mgierhart/Roku-ESP32-Remote/hardware/stl/lid.stl

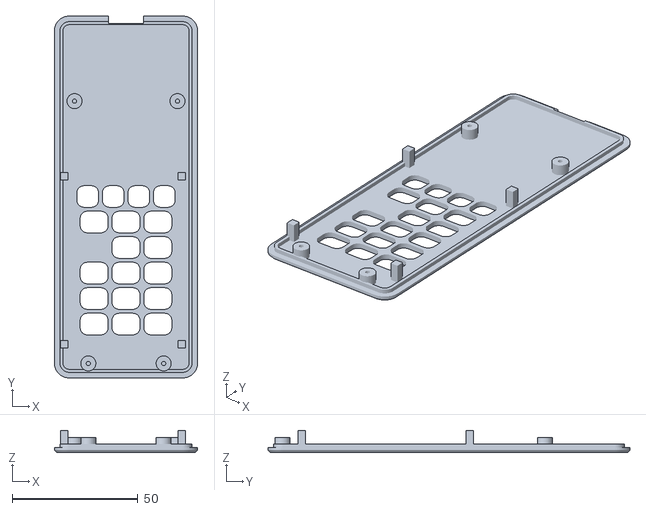
[picture p1: CAD file, 2026-10-26]
hardware/stl/lid.stl
57.1 x 144.2 x 8.80
