mgierhart/Roku-ESP32-Remote/(commit log)

2023-05-07 Create code
    Coded on an ESP32-WROOM-32 board in the Arduino IDE
2023-05-27 Update roku_remote.ino
    Changed global delay after button press from 50 to 150 to help prevent double-presses.
    [roku_remote.ino]
2023-05-27 Update README.md
    Added info for "Info (Star Button)" pin
2026-10-25 v2: auto-discover Roku, add HDMI input switching, move Wi-Fi creds to secrets.h
    - Find the Roku via SSDP (ST: roku:ecp) instead of a hardcoded IP; cache it
    in flash and rediscover when a key press can't connect
    - Add InputHDMI1-3 buttons (works over ECP on Roku OS 16 Streambar via CEC)
    - Move Wi-Fi credentials to git-ignored secrets.h with an example template
    - Table-driven buttons with non-blocking debounce and hold-to-repeat
    - Auto-reconnect Wi-Fi; log 403 hint for "Control by mobile apps"
    - Move sketch into roku_remote/ so the IDE picks up secrets.h; update README
    Claude-Session: https://claude.ai/code/session_01B3VZpqVy6EVJT5XtrG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
2026-10-25 Add HDMI 4 input button; clarify which input keys were tested
    - Add InputHDMI4 on GPIO 18 so the pin table covers all four HDMI keys
    - README: only InputHDMI1 has been confirmed on the Streambar; note the
    others are untested and how to remove unused inputs
    Claude-Session: https://claude.ai/code/session_01B3VZpqVy6EVJT5XtrGs663
2026-10-26 Add 3D-printable handheld case, parts list and wiring guide
    - hardware/roku_remote_case.scad: parametric OpenSCAD model (bottom shell,
    faceplate, 18 labeled caps + spares, fit-test coupon) built around 6x6x7
    tactile switches on one 5x7 cm perfboard and a 38-pin USB-C ESP32
    - hardware/stl/: print-ready exports, all within a 190 x 216 mm bed,
    no supports; parts checked for collisions in OpenSCAD
    - hardware/BUILD.md: parts list with links, print settings, perfboard hole
    map per button, wiring and assembly steps (GPIOs unchanged)
    - README: link to the handheld build
    Claude-Session: https://claude.ai/code/session_01B3VZpqVy6EVJT5Xtr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
